l2skowron/IoT-PostureMonitor/Projekt_sem5/Dokumentacja/Dane_katalogowe/Programowanie_w_jezyku_Kotlin.pdf

# Programowanie w języku Kotlin

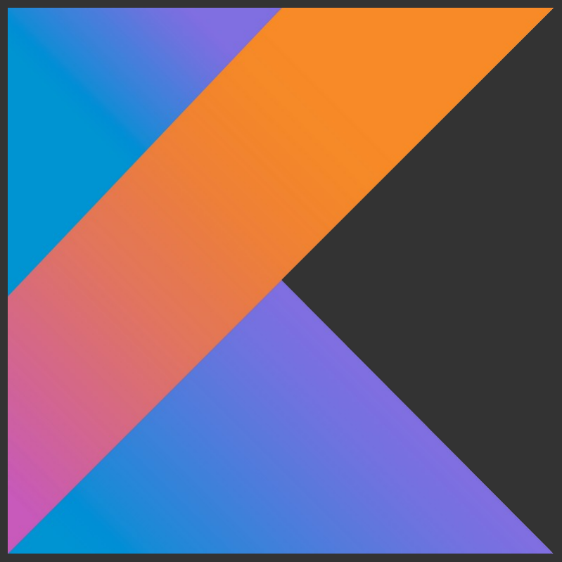
[picture p7: figure]

## dr inż. Michał Sawicki

## Politechnika Śląska

wersja: 15.10.2021

# Literatura

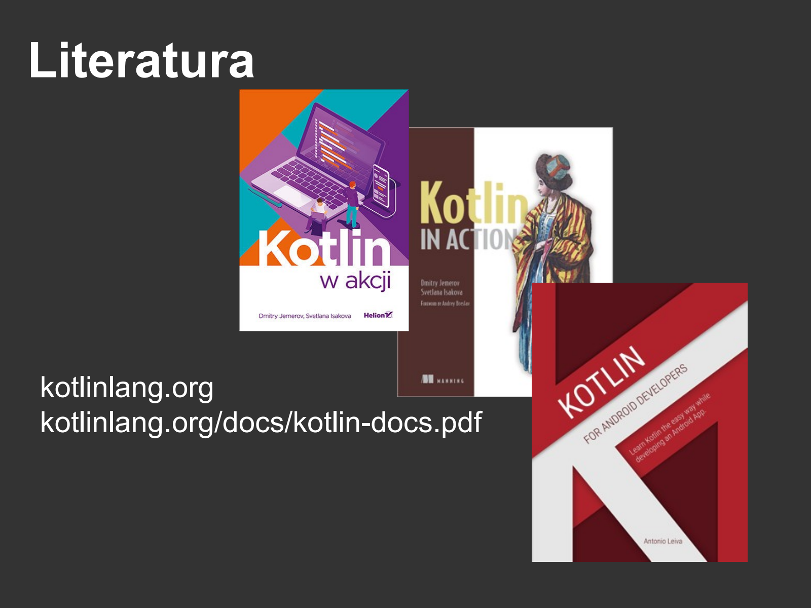
[picture p8: page 2]

## kotlinlang.org kotlinlang.org/docs/kotlin-docs.pdf

Nie tylko dinozaury...

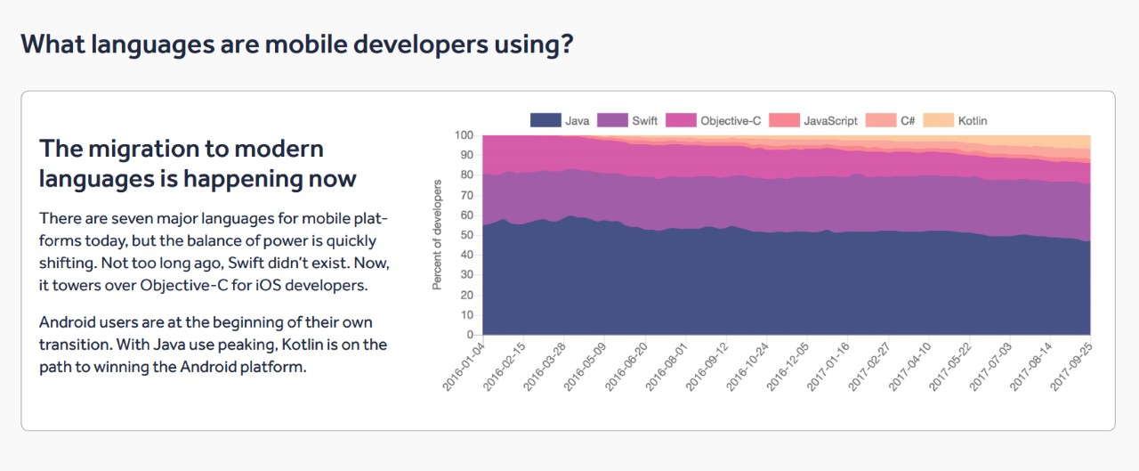
[picture p9: figure]

## Java na Androidzie umiera. Deweloperzy, którzy nie będą się posługiwać Kotlinem, mogą wkrótce

podzielić los dinozaurów...

# Kotlin – ogólna charakterystyka

## λ Cel: naprawa problemów ze składnią Javy, wzbogacenie

języka o rozwiązania znane z innych języków.
λ Nie wymaga stosowania średników (średniki są opcjonalne). λ Kotlin jest kompatybilny z JDK6.

## λ Aplikacja napisana w Kotlinie działa nie wolniej niż aplikacja

napisana w Javie.

## λ Kotlin zapewnia w pełni interoperacyjność z Javą, możliwe

są rozwiązania hybrydowe.
λ Istnieje konwerter kodu z Javy do Kotlina.
λ Możliwa jest kompilacja kodu Kotlina do kodu maszynowego, nie pośredniego (z wykorzystaniem LLVM).

# Kotlin – ogólna charakterystyka

## λ W Kotlinie nie ma metod, są za to funkcje

członkowskie (lub prościej funkcje).

## λ Indeksy numerowane są od zera (jak w rodzinie

języka C).
λ Składowe klas domyślnie są publiczne.
λ W Kotlinie możliwe jest zagnieżdżanie funkcji. λ Pliki z kodem Kotlina mają rozszerzenie .kt.

## λ Klasą bazową dla wszystkich klas jest Any (nie

JObject).

# Kotlin

ü | Obiektowy
ü | Strukturalny
ü | Funkcyjny

ü

# Imperatywny ü Statycznie typowany

# Kotlin – zastosowanie

## λ Aplikacje desktopowe

## λ Aplikacje webowe (transkodowanie do JavaScript)

## λ Aplikacje wbudowane

## λ Aplikacje mobilne

# Warsztat programisty Kotlina

## - Maszyna wirtualna Javy (JVM) - Zintegrowane środowisko programistyczne (IDE) → IntelliJ IDEA → Eclipse (wymaga dodatku) → NetBeans (wymaga dodatku) → Online try.kotlinlang.org

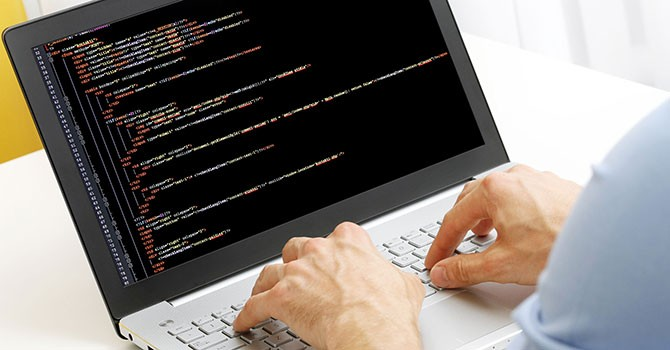
[picture p10: figure]

# Szkielet prostego programu

## package pl.polsl

## fun main(args :Array<String>) :Unit

{

## //cialo funkcji

}

Unit jest odpowiednikiem void i może być pomijany. Unit jest odpowiednikiem void i może być pomijany.

# Witaj Kotlinie!

## package pl.polsl

## fun main(args:Array<String>)

{

## println("Witaj Kotlinie!")

}

# Ciało blokowe funkcji

# package pl.polsl

# fun funkcja(): Int

{

# return 5

}

# Ciało wyrażeniowe funkcji

# package pl.polsl

# fun funkcja1(): Int = 5

# fun funkcja2() = 5

domniemanie typów

# Argumenty funkcji

## package pl.polsl

## fun funkcja(a: Int, b: Int, c: Int)

## funkcja(1,2,3)

## funkcja(a=1,b=2,c=3)

Wiele argumentów: vararg

# Podstawowe typy zmiennych

λ | Double (64)
λ | Float (32)
λ | Long (64)
λ | Int (32)
λ | Short (16)
λ | Byte (8)
λ | Char (nie może być traktowany jako liczba)
λ | Boolean (true, false)
λ | String
| W Kotlinie wszystko jest obiektem! W Kotlinie wszystko jest obiektem!

Przykłady wartości:
123
123L
0x0F
0b00110011 (nie ma zapisu oktalnego) 123.5
123.5e10
123.5f

# Deklaracja zmiennych

val – niemutowalna wartość zmiennej
var – mutowalna wartość zmiennej

val liczba: Int=5

val liczba=5

val liczba: Int
liczba=5

var liczba: Int=5
liczba=6

var liczba=5
liczba=6

Jeżeli zmienna (typ zerowalny) może przyjmować wartość null to musi to być wyraźnie zaznaczone poprzez ? : var zmienna :Typ?

Jeżeli zmienna (typ zerowalny) może przyjmować wartość null to musi to być wyraźnie zaznaczone poprzez ? : var zmienna :Typ?

# Rzutowanie jawne

## toByte() toShort() toInt() toLong() toFloat() toDouble() toChar()

### var liczba:Int=66 println(liczba.toChar())

# Tablice

λ | Tablice reprezentowane są przez generykę Array<T>, która zawiera funkcje get, set, size oraz przeciążony operator [].
λ | Tworzenie tablic z wykorzystaniem funkcji fabrykujących arrayOf() lub arrayOfNulls() lub z wykorzystaniem konstruktora Array(liczba, recepta_na_kolejne_wartości)
λ | Oddzielne klasy dla typów podstawowych: ByteArray, IntArray… i odpowiednio funkcje fabrykujące byteArrayOf, intArrayOf…
| var tablica1:IntArray=intArrayOf(1,2,3) println(tablica1[2])
| var tablica2= intArrayOf(1,2,3) println(tablica2.get(2))
| var slownik=arrayOf("Ala","ma","kota") println(slownik[1])
| var liczby1=Array<Int>(10,{i->i}) println(liczby1.get(2))
| var liczby2=Array(10,{i->i}) println(liczby2.get(2))

var tab=intArrayOf(1,2)
var tab2=tab
tab[0]=5
print(tab2[0])

Operator rozciągania:
*tab

# Łańcuchy znaków (String)

λ Łańcuchy znaków są niezmienne.

### λ Elementami łańcucha są znaki typu Char i jest dostęp do nich

poprzez operator [].

### λ Operatorem konkatenacji jest + (w tym rzutowanie niejawne, uwaga

na kolejność!).
λ Mogą zawierać znaki specjalne. Znak ucieczki to \ .

### λ Surowy łańcuch znaków z przejściami do nowych linii umieszczany

jest w ” ” ” ” ” ” .

### λ Szablony znakowe zawierają znak $, po którym podawane jest

wyrażenie.

# Szablony znakowe

λ Szablony znakowe (ze znakami specjalnymi lub surowe) zawierają znak $, po którym podawane jest wyrażenie.
λ Analogiczny mechanizm do rozwiązania z Basha.

val i=10
println("i=$i")

val s="abc"
println("$s.length wynosi ${s.length}")

val cena1=

"\$9.99"
val cena2=

"""${'$'}9.99"""

# Instrukcja warunkowa if

λ Instrukcja warunkowa if jest wyrażeniem, tj. może zwracać wartość. (Uwaga! try też może być wyrażeniem)
λ Nie ma operatora trynitarnego ? .
λ Jeżeli instrukcja if jest traktowana jako wyrażenie musi zawierać blok else.
λ Wyrażenie if może zawierać nietrywialne ciała (bloki), ale ostatnie wyrażenie w ciele jest wartością zwracaną przez blok.

if (1>0)
{
print("zawsze prawda")
}

println(if(1>1){print("uwaga!") "prawda"}
else{"falsz"})

# Instrukcja warunkowa when

λ Odpowiednik instrukcji switch.
λ Warunkiem nie musi być stała, może być wyrażeniem. λ Warunkiem może być weryfikacja typu.
λ Może być traktowana jako wyrażenie.
λ Alternatywa warunków za pomocą przecinka.

val a=0
println(when(a){
0 -> "zero"
0,1 -> "zero lub jeden"
in 0..10 -> "liczba z 0 do 10"
!in 20..30 -> "liczba poza 20 do 30" is Int -> "liczba typu Int"
else -> "sam juz nie wiem"
})

# Pętla for

λ Odpowiednik instrukcji foreach.

for (i in 1..3)
{
println(i)
}
for (i in 6 downTo 0 step 2) {
println(i)
}

# Pętle while i do..while

λ Działają jak w Javie.

var x=2
while(x>0)
{
println(x)
x--
}
do {
println(x)
x++
}while(x<2)

W Kotlinie mamy też W Kotlinie mamy też break i continue.

i | .

# Etykiety

λ Wykorzystywane do określenia poziomu zagnieżdżenia.

petlaZewnetrzna@ for (i in 1..10) {
petlaWewnetrzna@ for (j in 2..10) {
println(j)
if (i==j)
{
break@petlaZewnetrzna
}
}
}

# Lambda

{ /* argumenty */ -> /* cialo */ }

val suma = { x: Int, y: Int -> x+y }

{ it }

//Android - Java
button.setOnClickListener(new OnClickListener() {
@Override
public void onClick(View arg)
{
//cialo
}
});

//Android – Kotlin+lambda
button.setOnClickListener { /* cialo */ }

# Klasa

λ Słowo kluczowe class.
λ Klasa może nie mieć ciała.
λ Klasa domyślnie jest finalna, publiczna.

## λ Klasa może mieć podstawowy konstruktor i wiele

alternatywnych konstruktorów.
λ Ciało konstruktora podstawowego w bloku init.
λ Konstruktory alternatywne znajdują się w ciele klasy.

## λ Operatory == i ===

## λ Operator is

# Konstruktor podstawowy

class Student constructor(nazwisko: String) { }

class Student(nazwisko: String) { }

class Student(nazwisko: String)
{
val album=nazwisko
init
{
println("Po raz pierwszy mam studenta $nazwisko") }
val id=nazwisko
init
{
println("Drugi raz ten sam student $nazwisko") }
}

widoczność

# Konstruktor podstawowy – lista inicjalizacyjna

class Student(val nazwisko: String, var wiek: Int) {
//ciało klasy
}

# Konstruktor alternatywny i delegacja do innych konstruktorów

class Student
{
constructor(imie :String) {} }

Delegacja do konstruktora podstawowego:

class Student(val nazwisko :String)
{
constructor(nazwisko :String, imie :String) : this(nazwisko) {
//ciało konstruktora alternatywnego
}
}

# Konstruktor alternatywny i delegacja do innych konstruktorów

class Student
{
init
{
println("Podstawowy")
}
constructor(i: Int)
{
println("Alternatywny")
}
}

# Settery i gettery

class Student
{
var liczba: Int
get()
{
return liczba
}
set(n: Int)
{
liczba=n
}
}

class Student
{
var liczba: Int
get()=liczba
}

# Tworzenie obiektów klas

## val student1=Student()

## val student2=Student("Kowalski")

# NULL!

## obiekt?.funkcja()

## obiekt1 ?: obiekt2

## obiekt!!

asercja niezerowa

operator Elvisa

# Dziedziczenie klas

open class Figura(nazwa:String) {}

class Kwadrat(nazwa:String, bok:Int) : Figura(nazwa) {}

class Trojkat : Figura
{
constructor(nazwa:String) : super(nazwa) {}
}

super może być wykorzystane do wywołania funkcji klasy bazowej (lub zewnętrznej, możliwe etykiety) super może być wykorzystane do wywołania funkcji klasy bazowej (lub zewnętrznej, możliwe etykiety)

# Dziedziczenie klas – nadpisywanie funkcji

open class Figura
{
open fun funkcja1() {}
open fun funkcja2() {}
fun funkcja3() {}
}

open class Kwadrat:Figura
{
override fun funkcja1() {} final override funkcja2() {} }

# Dziedziczenie klas – nadpisywanie składników (pól)

open class Figura
{
open val i:Int get() {//ciało funkcji get} }

class Kwadrat:Figura
{
override val i:Int=0
}

class Trojkat(override val i:Int):Figura {}

class Kolo:Figura
{
override var i:Int=1
}

val → var val → var

# Implementacja interfejsu

# interface IFigura

{

# fun funkcja()

}

# class Kwadrat: IFigura

{

# override fun funkcja() {}

}

# Widoczność składników

## èPubliczna (public) – pola i metody dostępne na zewnątrz klasy

## èWewnętrzna (internal) – podobnie jak public, ale tylko wewnątrz modułu

## èPrywatna (private) – pola i metody dostępne jedynie z wnętrza (ciała) klasy

## èChronione (protected) – pola i metody dostępne tylko z wnętrza klasy lub klasy pochodnej

# Funkcja rozszerzająca

package strings

fun String.lastChar(): Char = this.get(this.length-1)

println("Politechnika".lastChar())

odbiorca

# Klasa wyliczeniowa

# enum class Plec { MEN, WOMEN

}

miękkie słowo kluczowe

## Klasa wyliczeniowa: - może zawierać funkcje

# Klasa i obiekt w jednym

### fun main(arg:Array<String>)

{

### Dyrektor.przedstawSie()

}

### object Dyrektor

{

### private val nazwisko="Kowalski" fun przedstawSie()

{

### println(nazwisko)

}
}

# Inne elementy Kotlina

## èKlasy danych (data class)

## èKlasy zamknięte (sealed class)

## èGeneryki (analogicznie jak w Javie)

## èOperator !== oraz :: - pobranie referencji funkcji

## èFunkcje standardowe

# Android lubi Kotlina

class MainActivity : Activity(), View.OnClickListener {
override fun onCreate(savedInstanceState: Bundle?) {
super.onCreate(savedInstanceState) setContentView(R.layout.activity_main)
val przycisk: Button =findViewById(R.id.button) przycisk.setOnClickListener(this)
}
override fun onClick(v: View?)
{
Toast.makeText(applicationContext,"Hello",Toast.LENGTH_SHORT).show() }
}
