l2skowron/IoT-PostureMonitor/Projekt_sem5/Dokumentacja/Karta.projektu.v.1_Łukasz.Skowron.pdf

| Katedra Grafiki Wizji Komputerowej i Systemów Cyfrowych Karta projektu SMiW

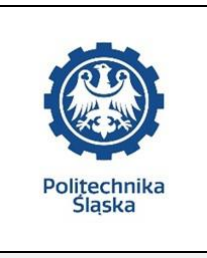
[picture p13: figure]

Rok akademicki | Rodzaj studiów*: SSI Glw/SSI Ktw/NSI Glw | Dizeń tygodnia i godzina zajęć: | Numer sekcji:
2024/2025 | SSI Glw | Poniedziałek 11:30 | 2
Imię: Nazwisko: | Łukasz | Prowadzący (inicjały): OA/JP/GB/KP | JP

## Skowron

## Temat projektu

Nakładka na fotel monitorująca postawę użytkownika.

Opis głównych założeń projektu:

Materiałowa nakładka umożliwiająca montaż na większość foteli komputerowych. Zbieranie danych z pomocą czujników tensometrycznych. Czujniki umieszczone pod udami siedzącego o zakresie pomiarowym do 50 kg. Czujniki umieszczone na oparciu w odcinku lędźwiowym, środkowym i na wysokości łopatek o zakresie pomiarowym do 20 kg. Bezprzewodowa komunikacja pomiędzy mikrokontrolerami (pomiarowym i odpowiedzialnym za wyświetlacz). Możliwość kalibracji poprawnej postawy użytkownika z pomocą ekranu. Sygnalizacja stanu postawy z pomocą diody RGB.

Rodzaj zasilania:

Stałe, dla modułu z wyświetlaczem. Bateryjne, dla modułu pomiarowego przymocowanego do nakładki.
