l2skowron/IoT-PostureMonitor/Projekty PCB/Projekt podłączenia/Moduł_pomiarowy_Łukasz.Skowron_mnt.png

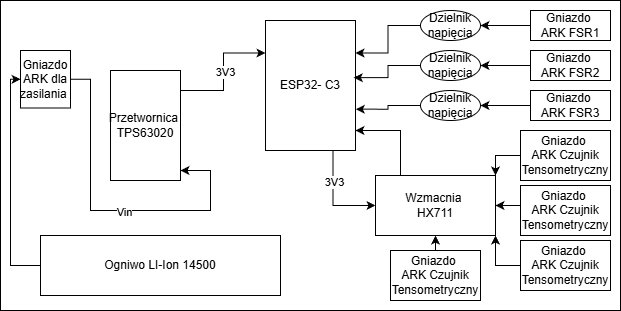
Projekty PCB/Projekt podłączenia/Moduł_pomiarowy_Łukasz.Skowron_mnt.png
