l2skowron/IoT-PostureMonitor/Schematy blokowe/Analiza_i_wybór_elementów_moduł_UI.png

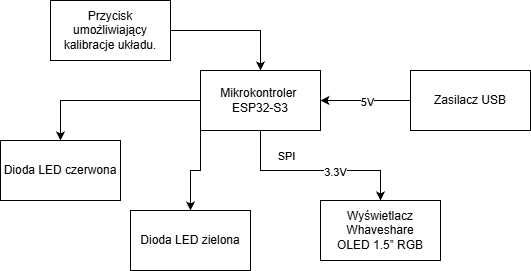
Schematy blokowe/Analiza_i_wybór_elementów_moduł_UI.png
