l2skowron/IoT-PostureMonitor/Schematy ideowe/Schemat_moduł_pomiarowy.png

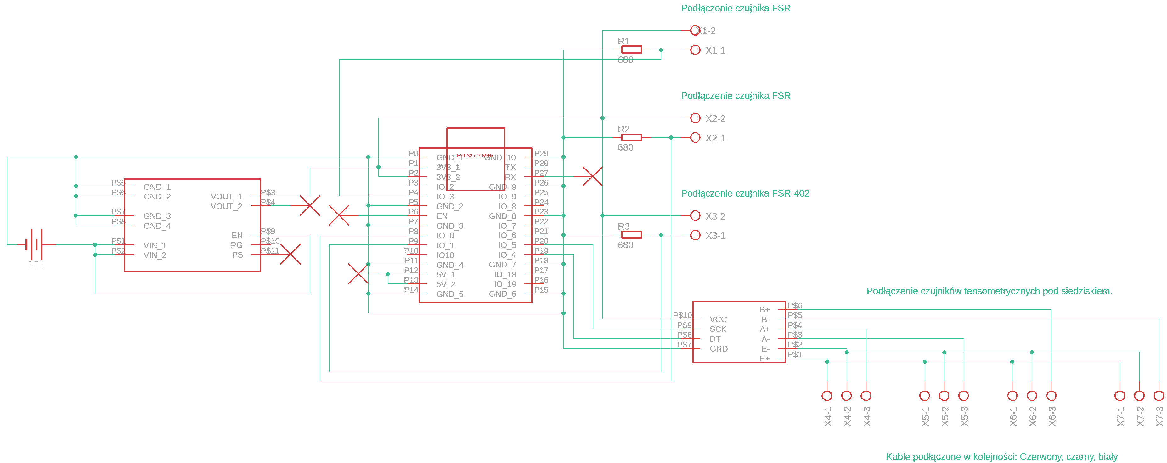
Schematy ideowe/Schemat_moduł_pomiarowy.png
