l2skowron/IoT-PostureMonitor/Schematy ideowe/Schemat_moduł_wyświetlacza.png

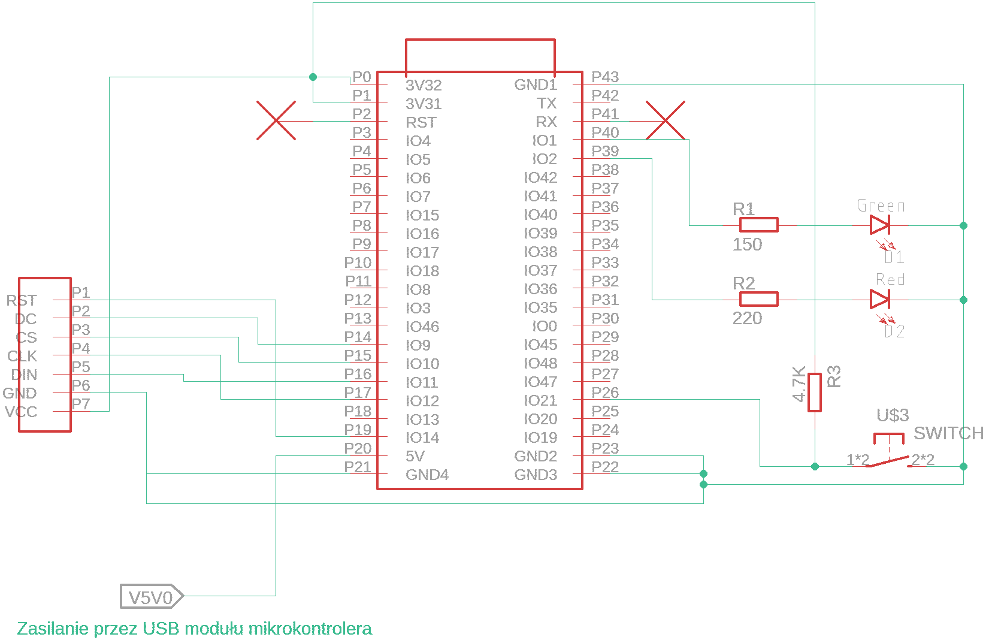
Schematy ideowe/Schemat_moduł_wyświetlacza.png
