l2skowron/IoT-PostureMonitor/Projekt_sem5/CHANGELOG.md

# Changelog	

Wszystkie istotne zmiany podczas tworzenia projektu zostały umieszczone w tym pliku.
## [1.1] - 2026-02-03

## Dodano
- prezentacja działania układu

## [1.0] - 2026-02-02

## Dodano
- dodanie nowego modułu przetwornicy,
- stworzenie pierwszej pełnej wersji finalnej.

## [0.9] - 2026-01-29

## Dodano 
-  dodanie podkładki na czujnikach zlokalizowanych na oparciu w celu lepszego pobierania nacisku.
-  implementacja tymczasowego zasilania bateryjnego z użyciem stabilizatora zlokalizowanego na module mikrokontrolera.
## [0.8] - 2026-01-27

## Dodano
- ukończenie implementacji modułu wyświetlacza,
- dodanie obsługi kalibracji oraz ekranów komunikacyjnych.
- implementacja zasilania bateryjnego modułu pomiarowego/awaria przetwornicy.

## [0.7] - 2026-01-25

## Dodano
- ukończenie implementacji modułu pomiarowego, w wersji z zasilaniem sieciowym.
- rozpoczęcie programowania układu.
- dodanie filtru medianowego dla ujednolicenia pomiarów czujnikami tensometrycznymi.

## [0.6] - 2026-01-21

### Dodano
- stworzenie prezentacji biznesowej projektu.
- rozpoczęcie montowania wersji finalnej projektu.

## [0.5] - 2026-01-10

### Dodano
- aktualizacja schematu ideowego.
- stworzenie projektu płytki PCB.
- zaprogramowanie komunikacji z pomocą protokołu ESP-NOW.

## [0.4] - 2025-12-12

### Dodano
- utworzenie pierwszego schematu podłączeń układu.
- rozpoczęcie testów poszczególnych komponentów układu:
	-czujników FSR,
	-wyświetlacza.

## [0.3] - 2025-11-30

### Dodano
- Ukończenie pełnej analizy tematu.
- Przesłanie pliku Analiza.v.1_Łukasz.Skowron.
- Zamówienie potrzebnych komponentów.

## [0.2] - 2025-11-10

### Dodano
- utworzenie pliku Analiza.v.1_Łukasz.Skowron podsumowującego użyte elementy i plany projektowe.
- dalsza analiza tematu. 

## [0.1] - 2025-10-21

### Dodano
- stworzenie karty projektu podsumowującej założenia.
- wstępna analiza tematu. Analiza możliwości implementacyjnych.
