l2skowron/IoT-PostureMonitor/Projekt_sem5/Hardware/PDF/Moduł_pomiarowy/Moduł_pomiarowy.v.1_Łukasz.Skowron.pdf

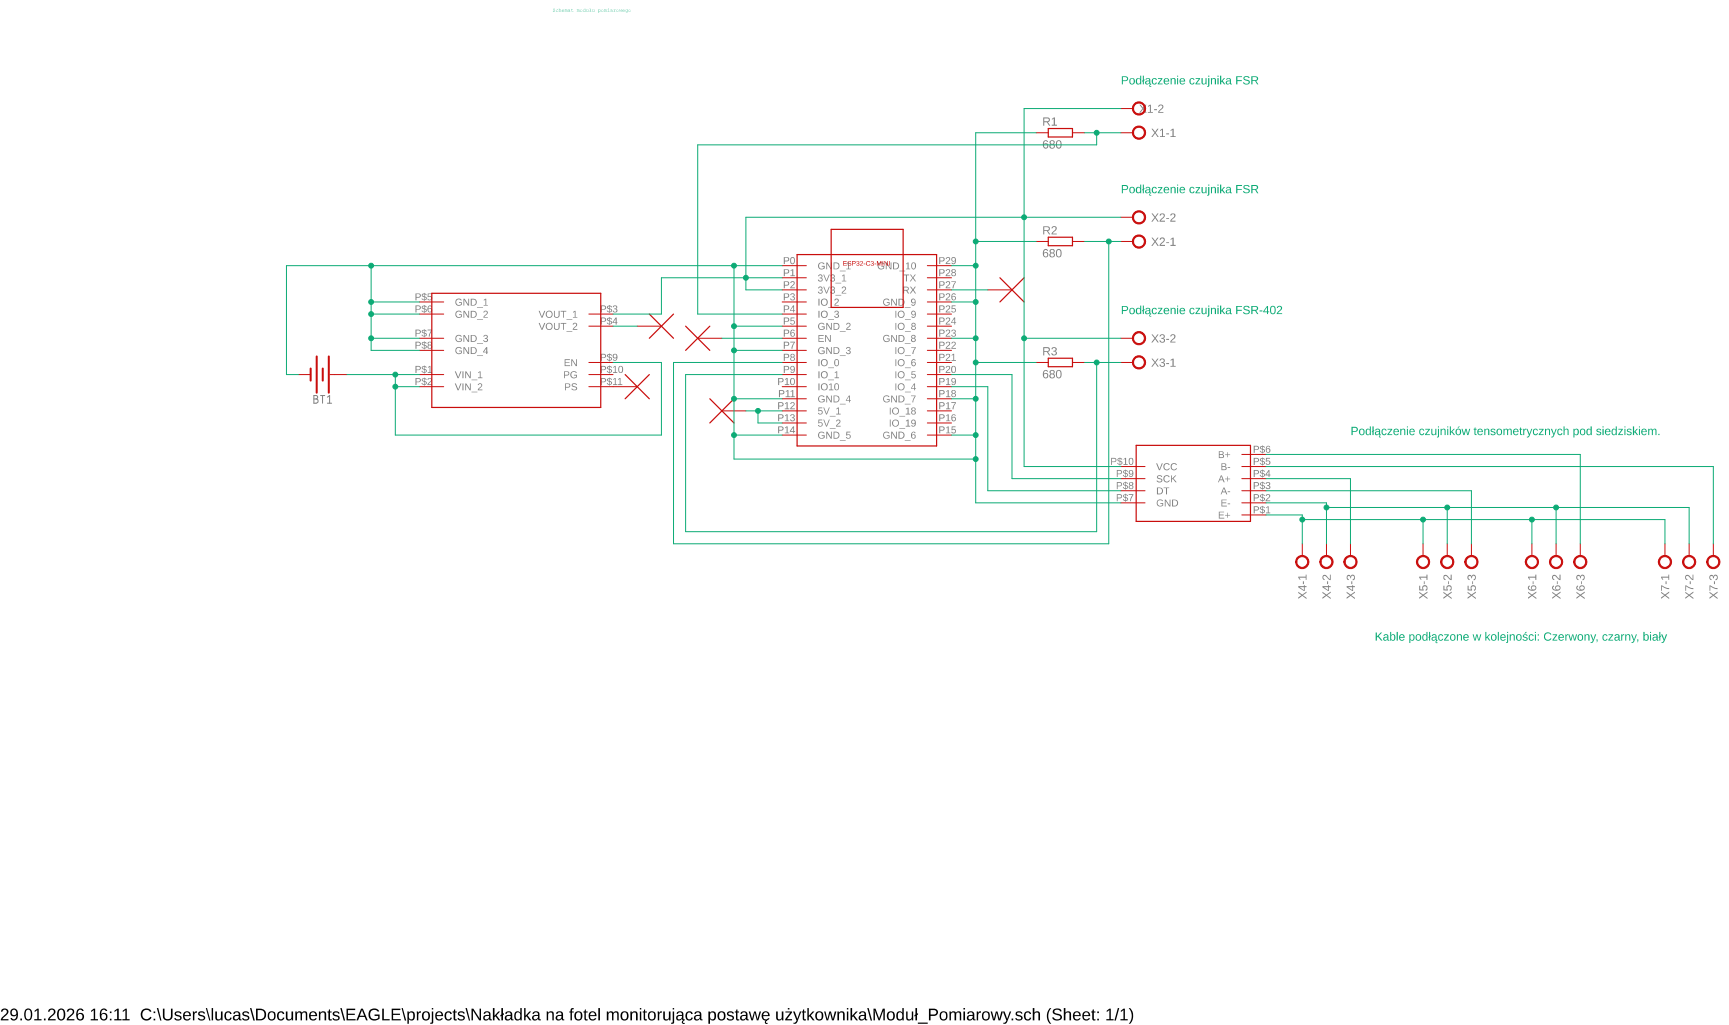
[picture p32: page 1]
