l2skowron/IoT-PostureMonitor/Projekt_sem5/Hardware/PDF/Moduł_pomiarowy/Moduł_pomiarowy_ŁukaszSkowron_bot.pdf

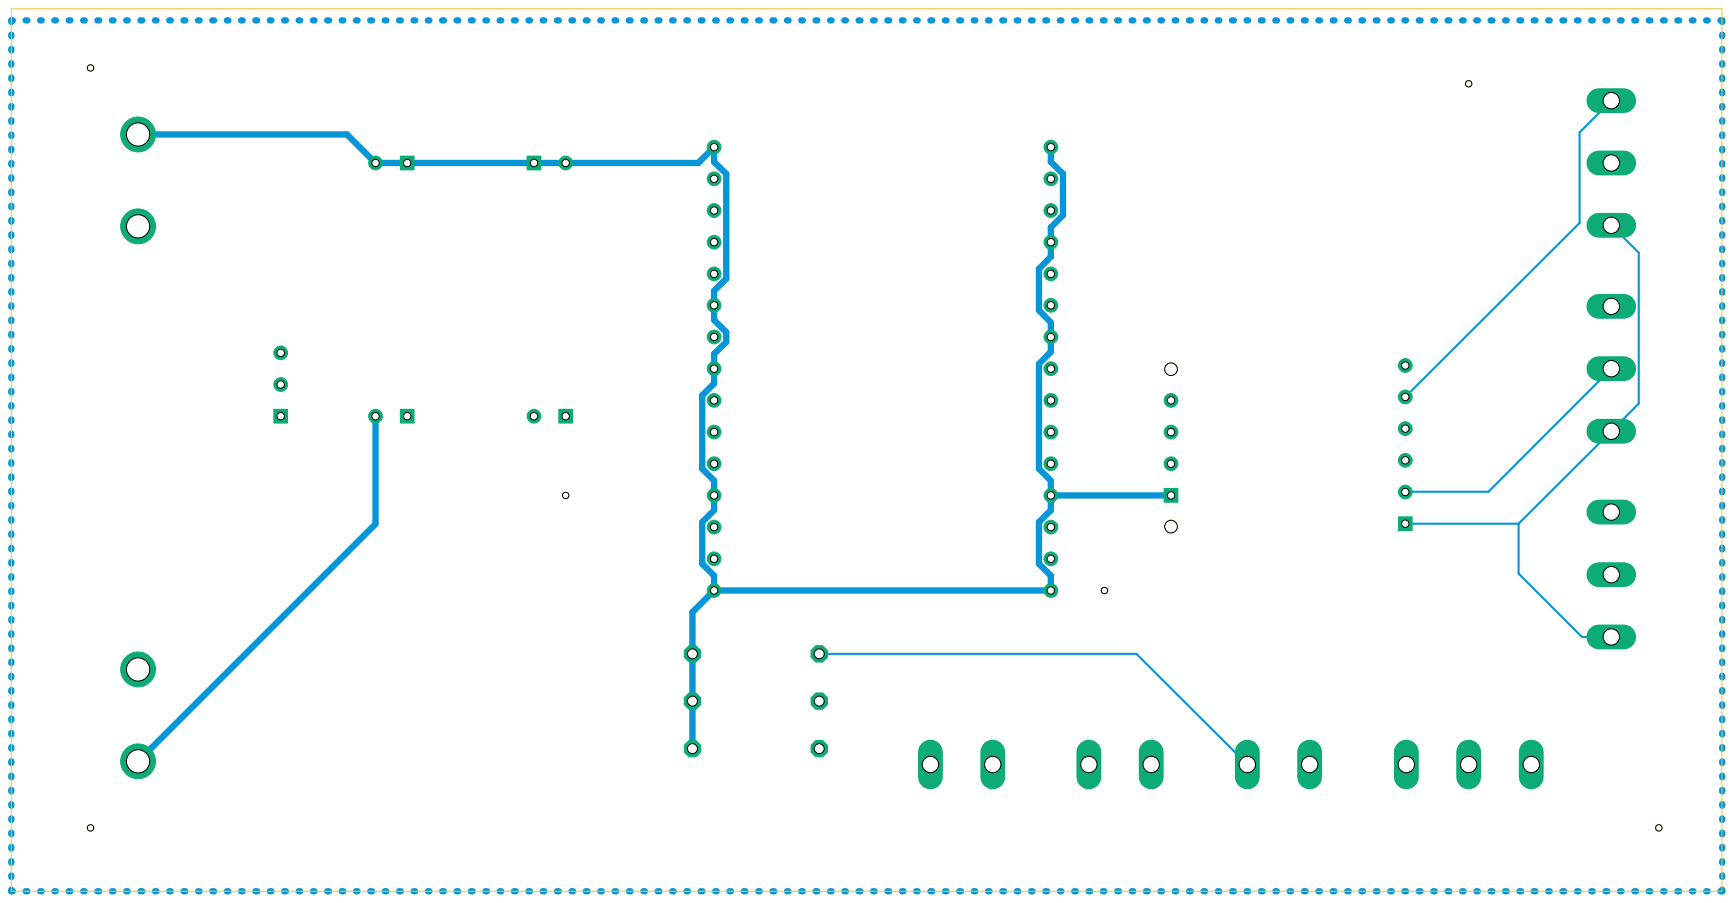
[picture p33: page 1]
