l2skowron/IoT-PostureMonitor/Projekt_sem5/Hardware/PDF/Moduł_pomiarowy/Moduł_pomiarowy_ŁukaszSkowron_bot_gnd.pdf

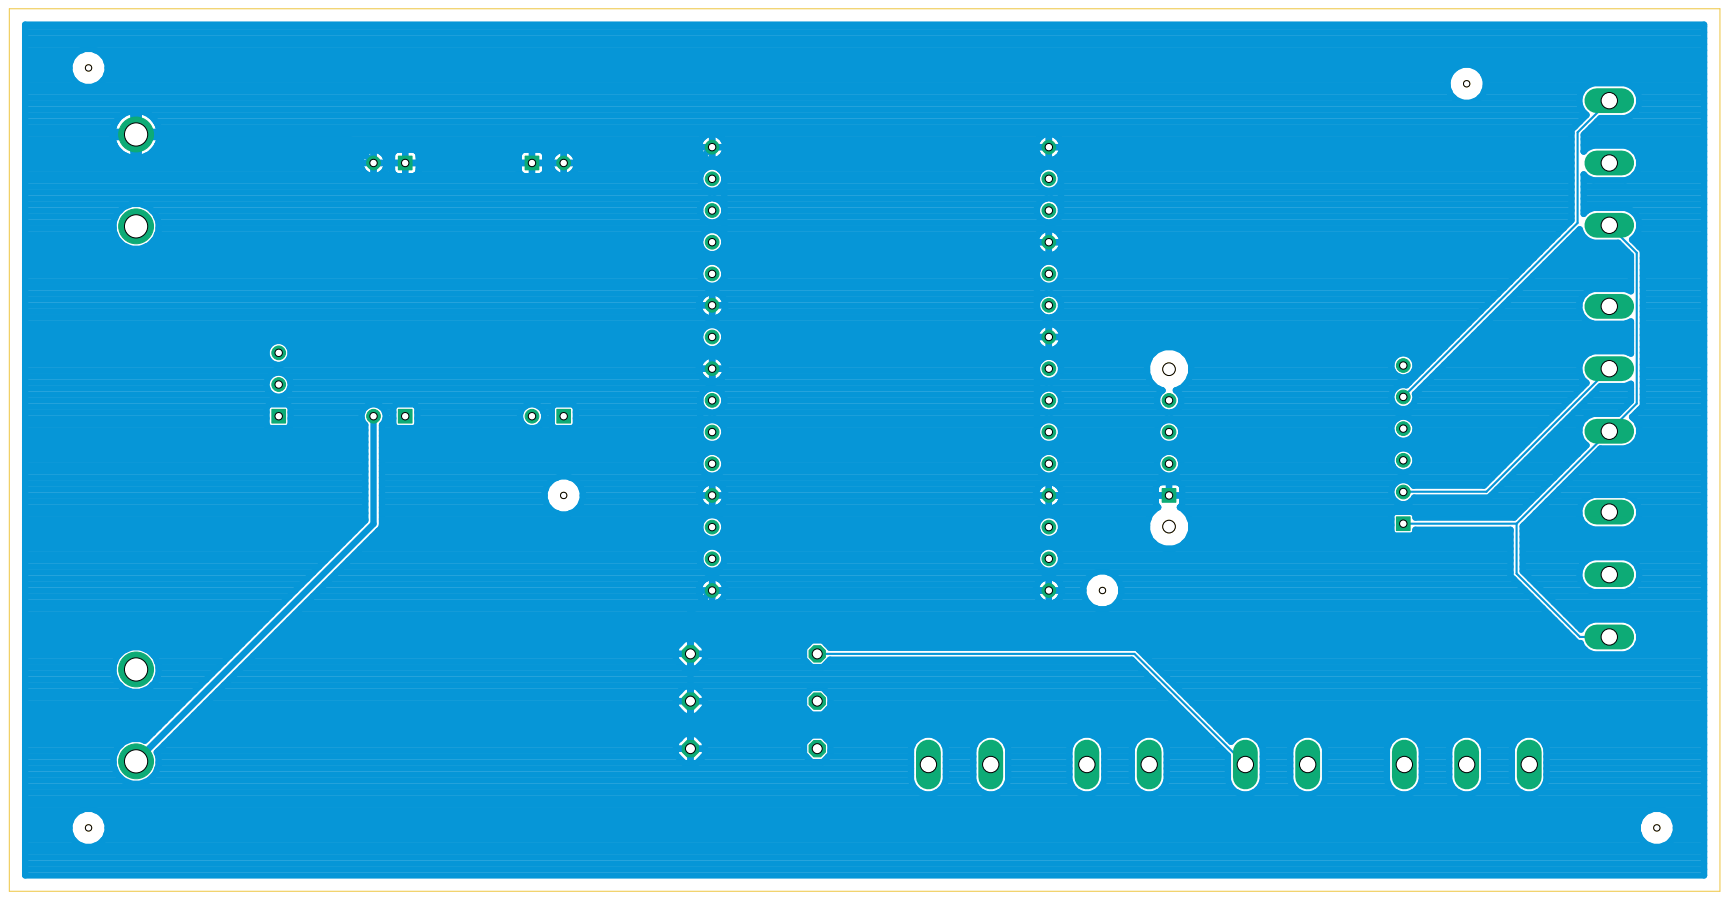
[picture p34: page 1]
