l2skowron/IoT-PostureMonitor/Projekt_sem5/Hardware/PDF/Moduł_pomiarowy/Moduł_pomiarowy_ŁukaszSkowron_top.pdf

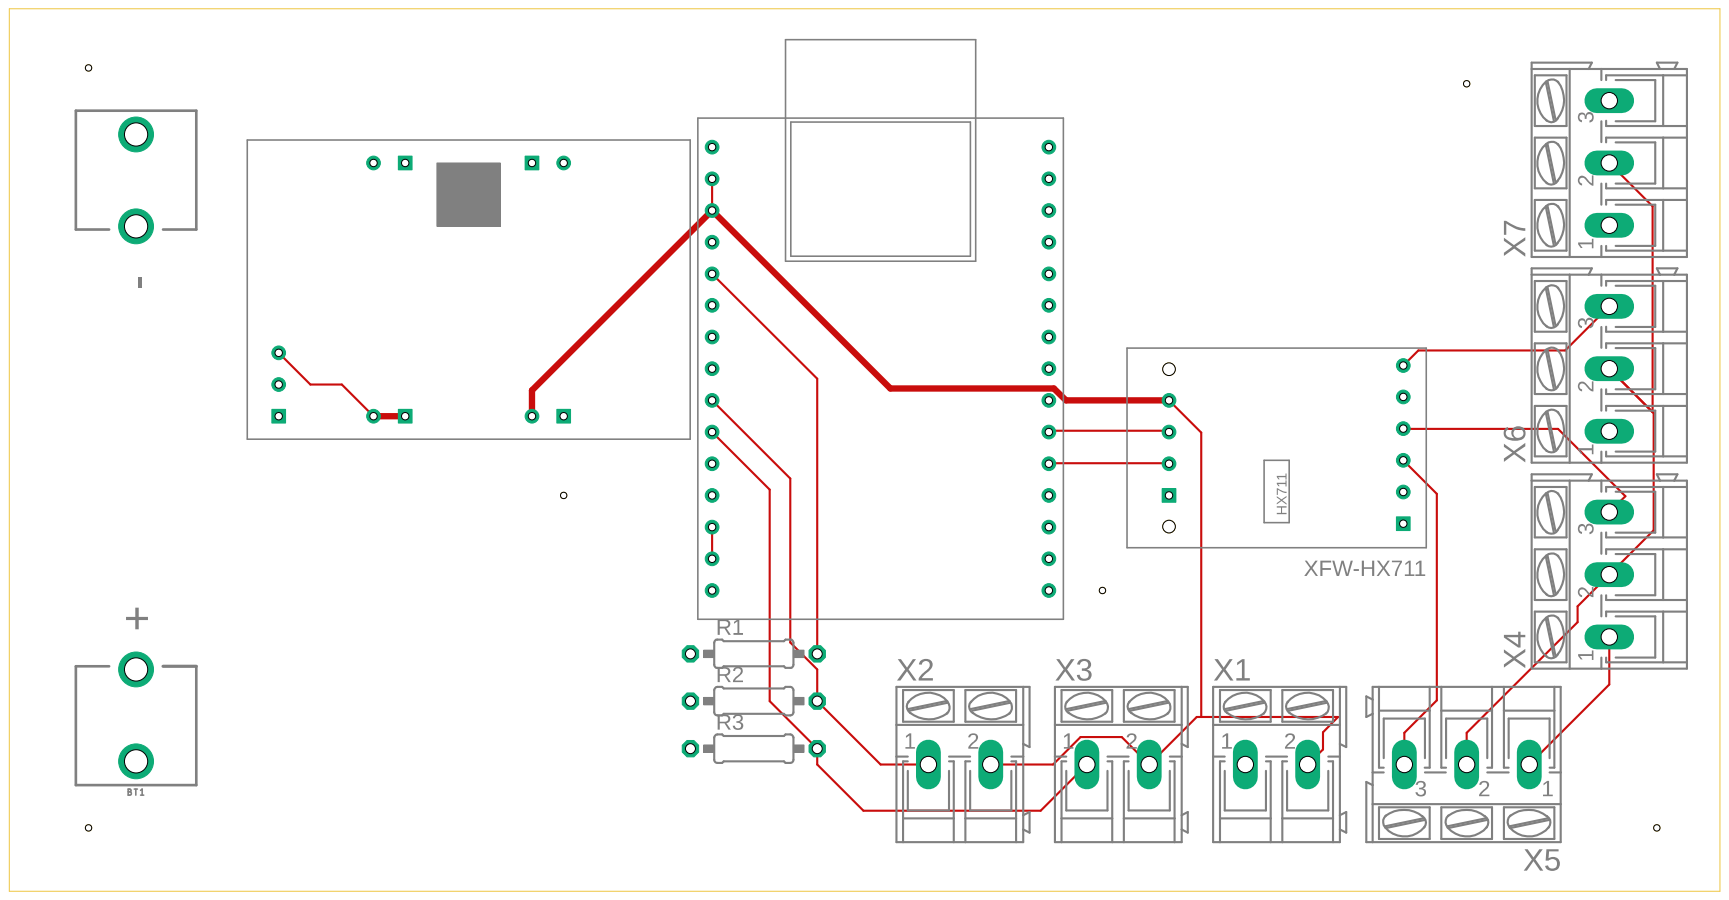
[picture p35: page 1]
