l2skowron/IoT-PostureMonitor/Projekt_sem5/Hardware/PDF/Moduł_wyświetlacza/Moduł_wyświetlacza.v.1_Łukasz.Skowron.pdf

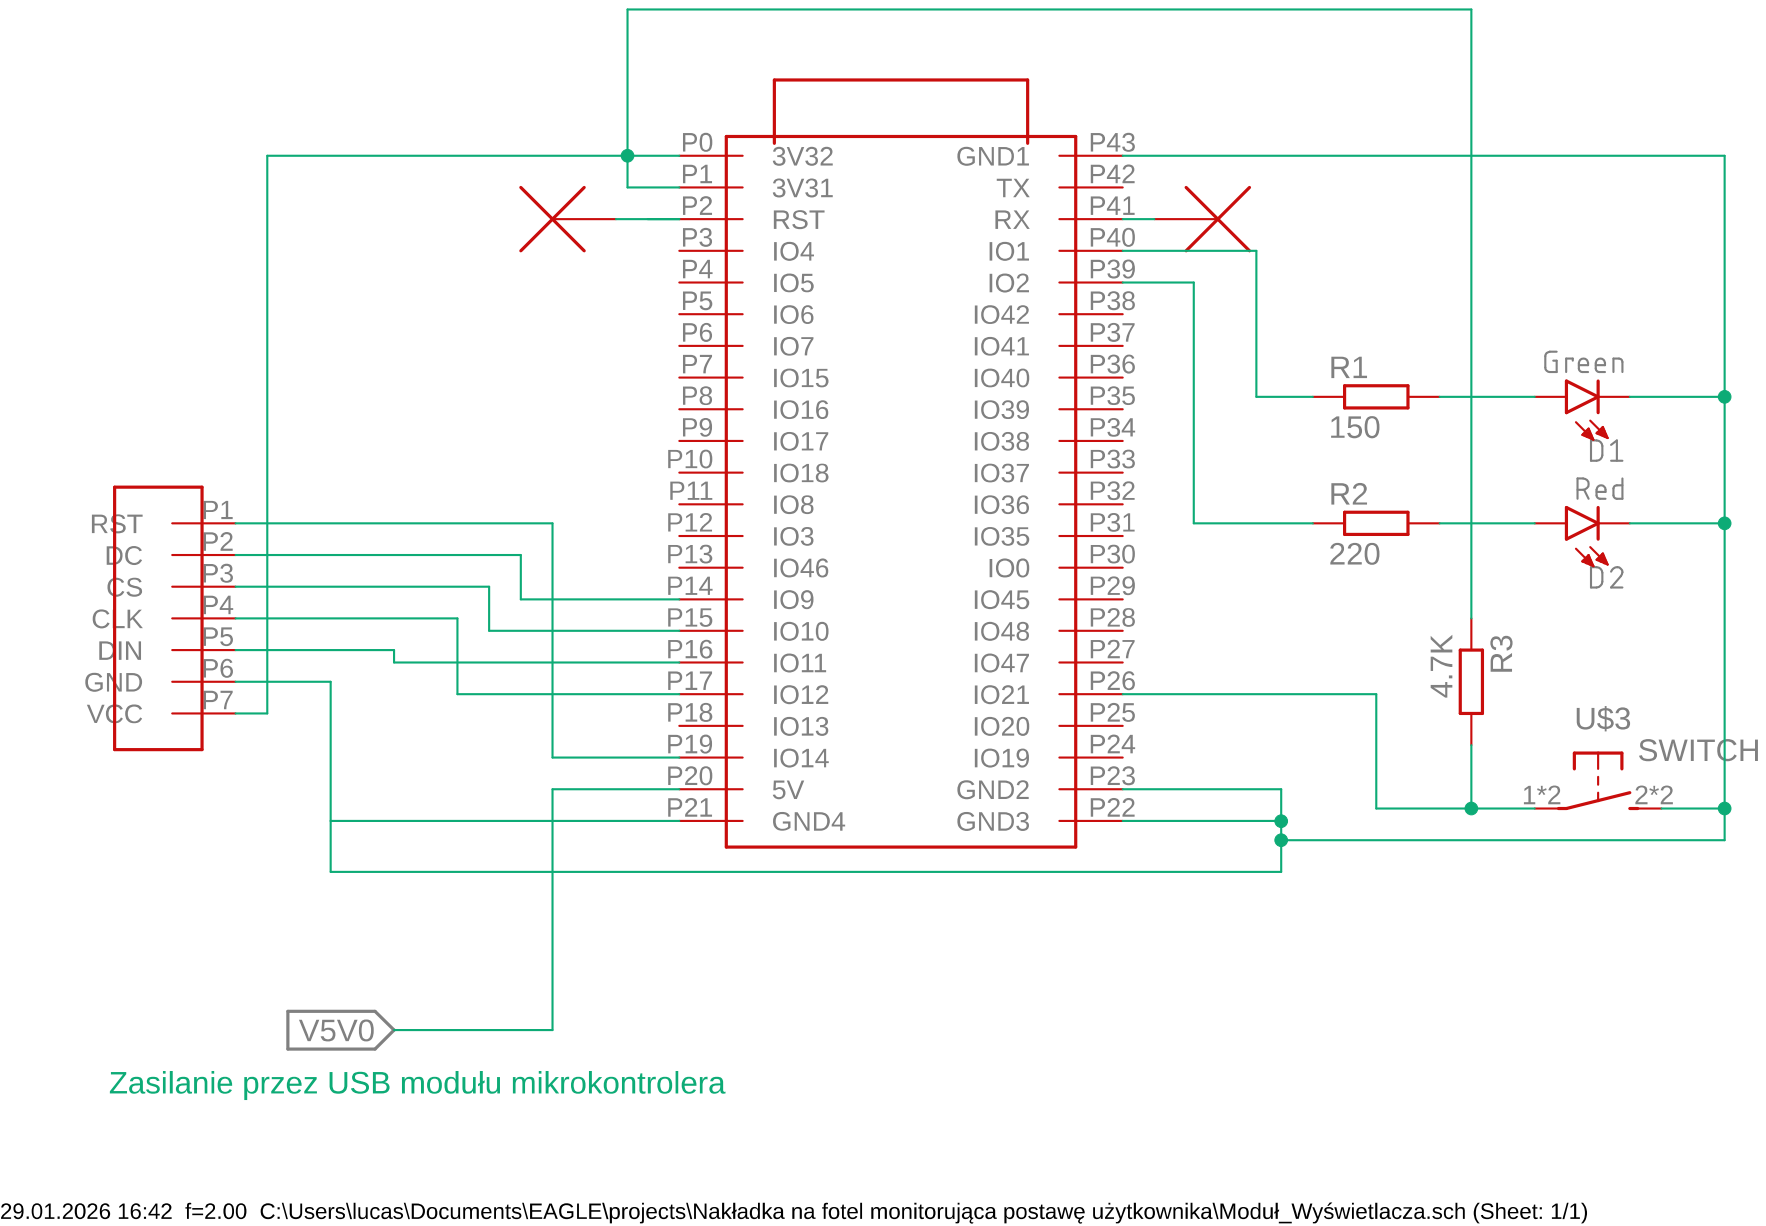
[picture p36: page 1]
