l2skowron/IoT-PostureMonitor/Projekt_sem5/Hardware/PDF/Moduł_wyświetlacza/Moduł_wyświetlacza_ŁukaszSkowron_bot.pdf

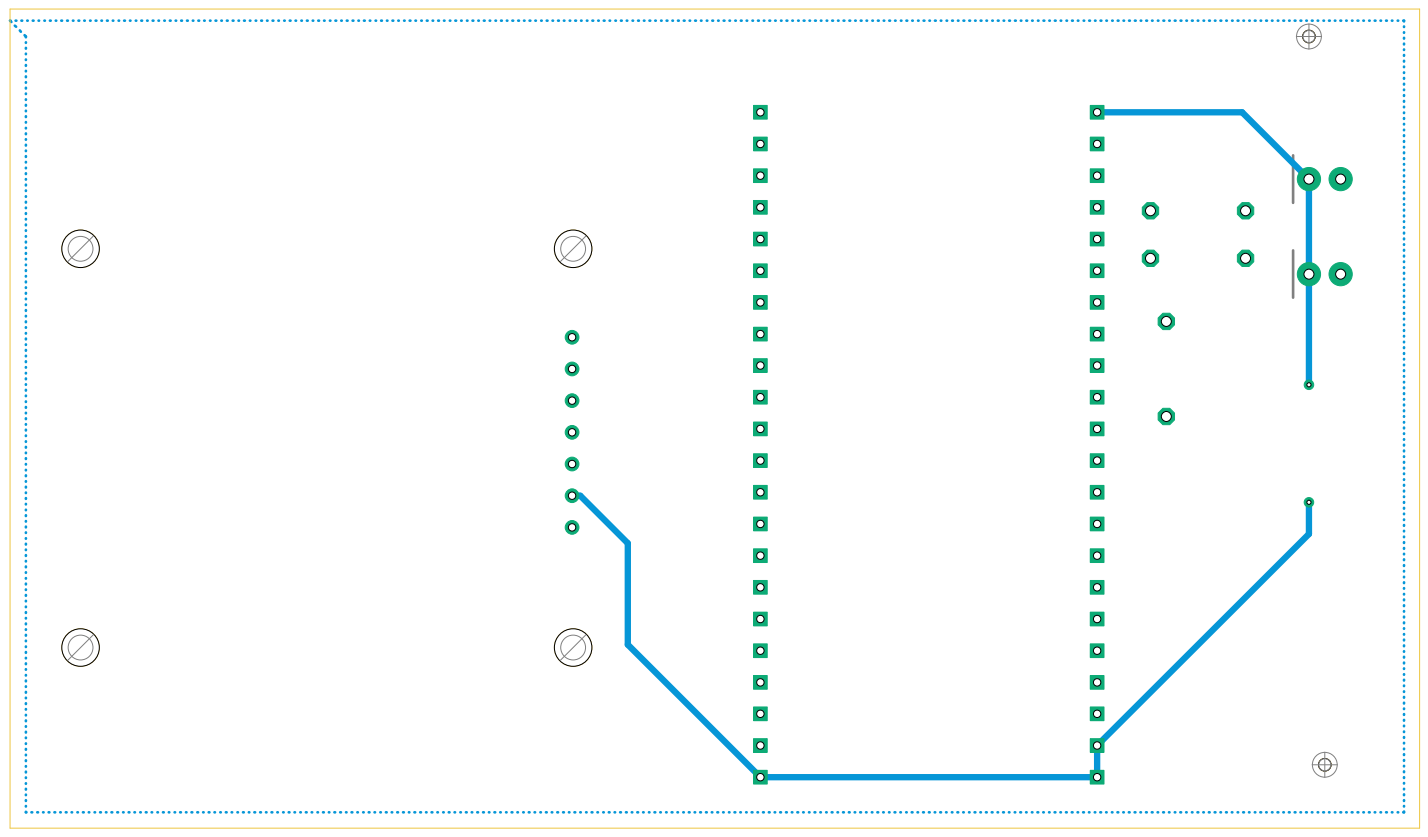
[picture p37: page 1]
