l2skowron/IoT-PostureMonitor/Projekt_sem5/Hardware/PDF/Moduł_wyświetlacza/Moduł_wyświetlacza_ŁukaszSkowron_bot_gnd.pdf

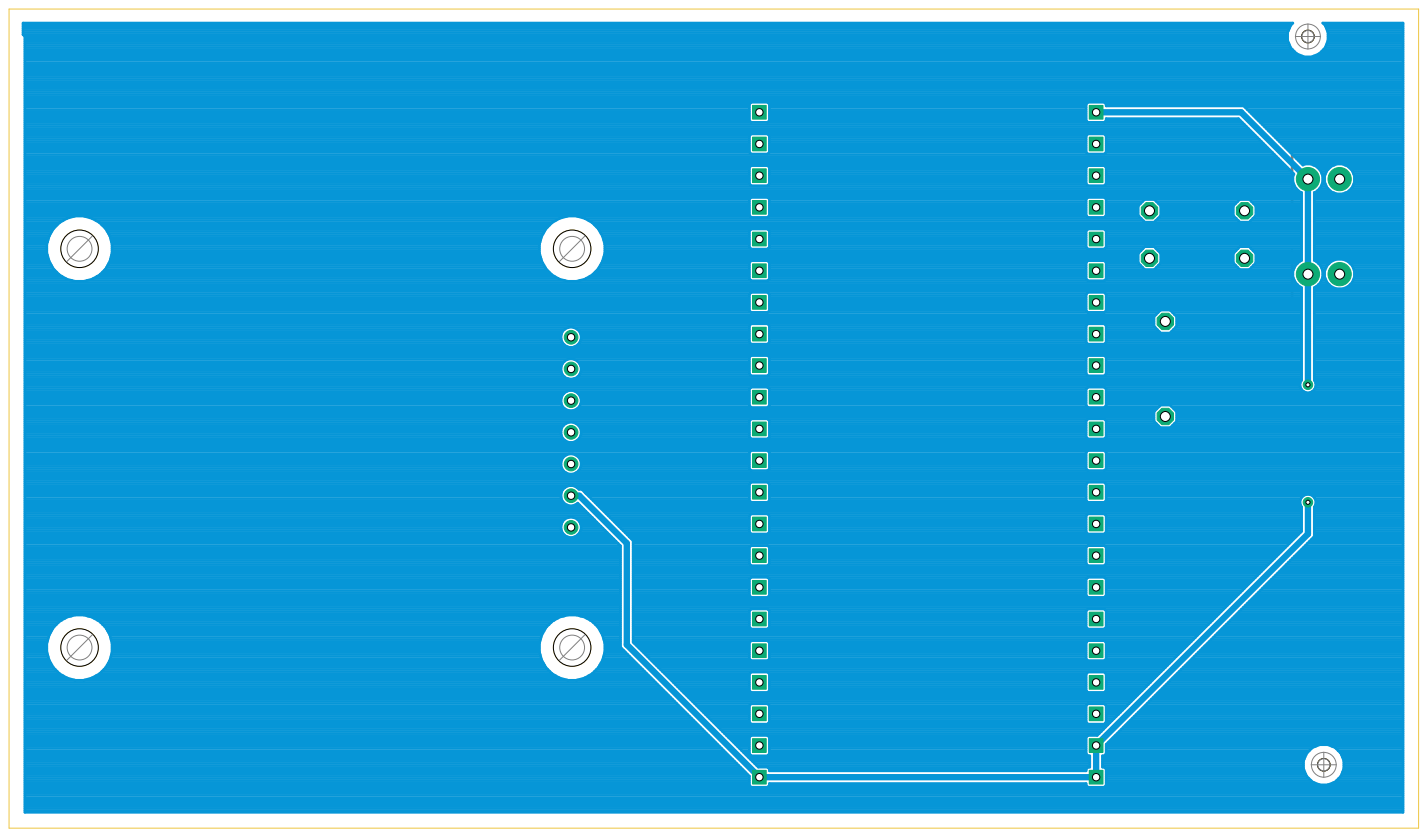
[picture p38: page 1]
