l2skowron/IoT-PostureMonitor/Projekt_sem5/Hardware/PDF/Moduł_wyświetlacza/Moduł_wyświetlacza_ŁukaszSkowron_top.pdf

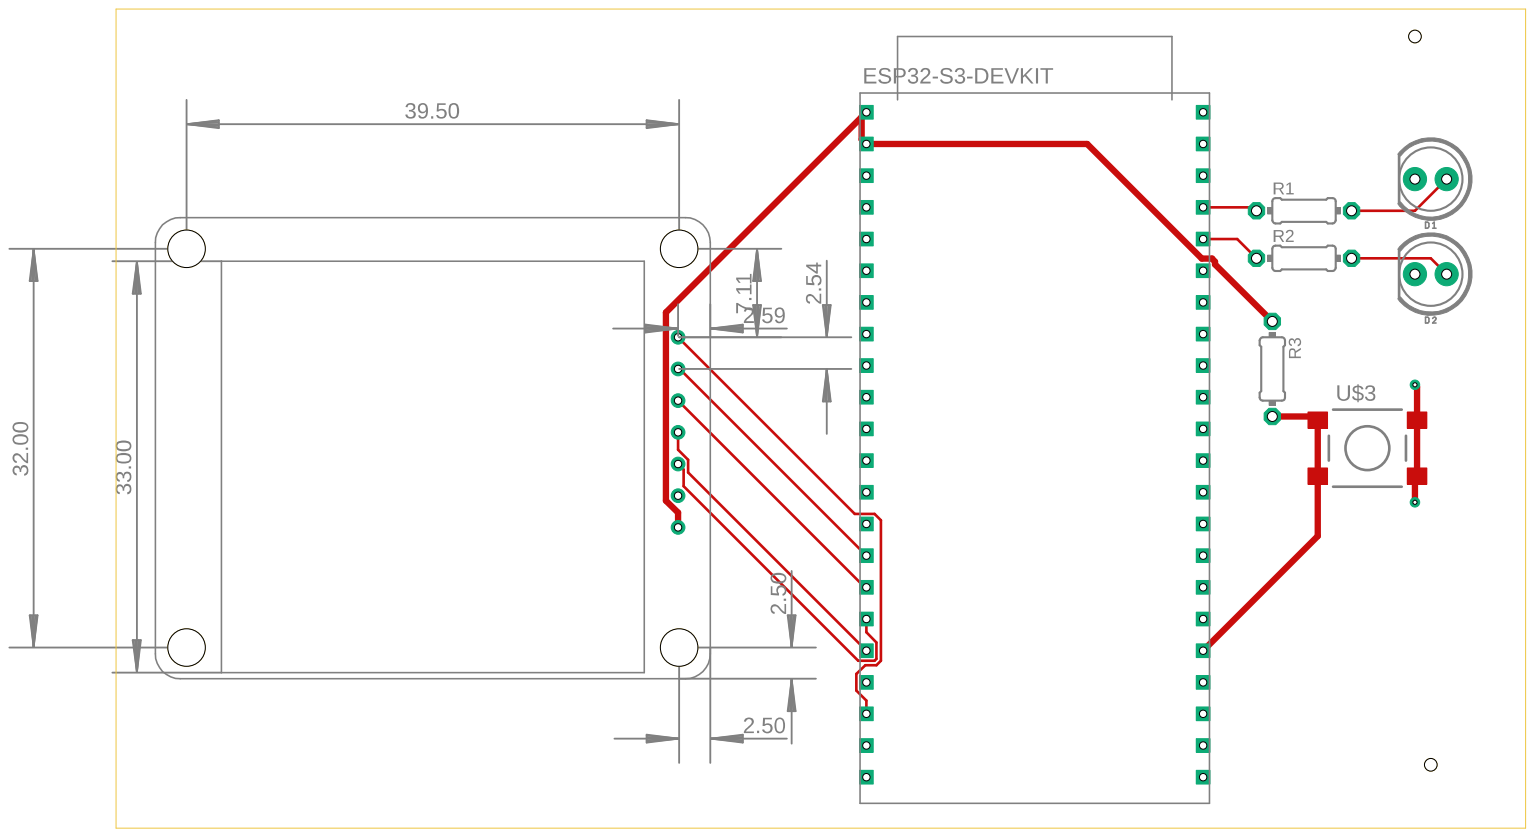
[picture p39: page 1]
