l2skowron/IoT-PostureMonitor/Projekt_sem5/Hardware/EAGLE/Moduł_wyświetlacza/Moduł_Wyświetlacza.brd

## EAGLE design Projekt_sem5/Hardware/EAGLE/Moduł_wyświetlacza/Moduł_Wyświetlacza.brd (2026-03-30)

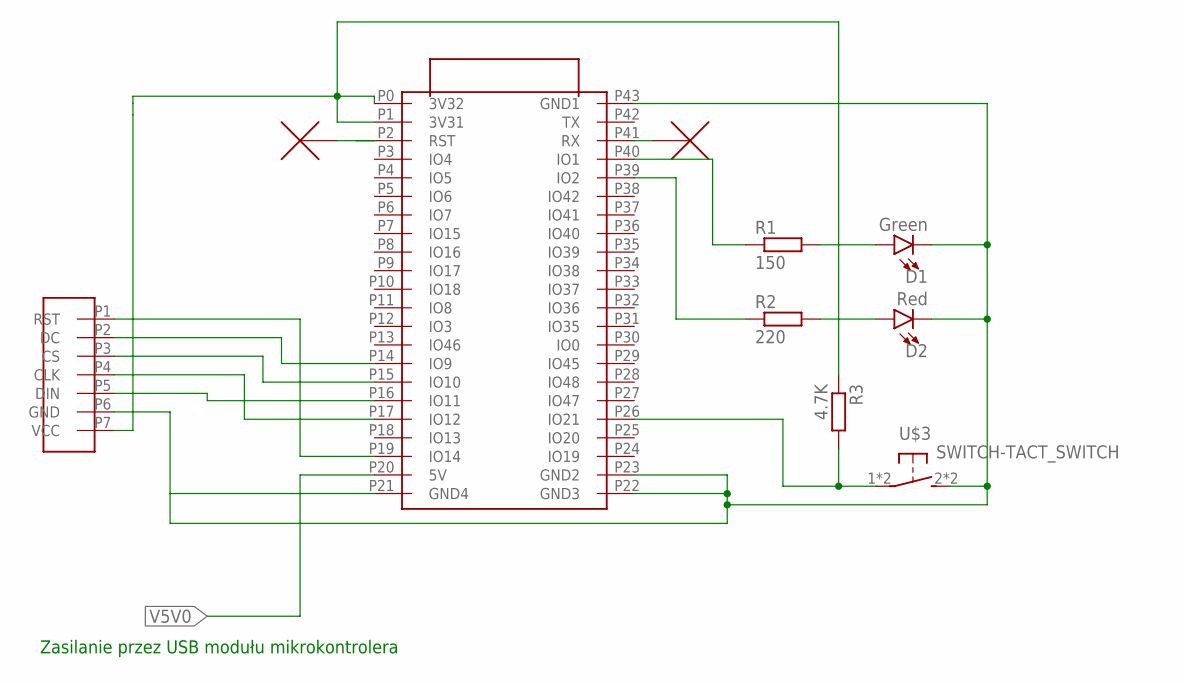
[picture p40: schematic Moduł_Wyświetlacza.sch]

Parts:
D1: Green; SPARKFUN-LED_LED_5MM
D2: Red; SPARKFUN-LED_LED_5MM
R1: 150; 0204/7
R2: 220; 0204/7
R3: 4.7K; 0204/7
U$1: PROJEKT_SE5_ESP32-S3-DEVKIT
U$2: PROJEKT_SE5_OLED_MODULE; PROJEKT_SE5_1.5INC_RGB_OLED
U$3: SWITCH-TACT_SWITCH; SWITCH-TACT_DTSM-6

Connections:
unnamed: D1.K (C), D2.K (C), U$1.P21 (GND4), U$1.P22 (GND3), U$1.P23 (GND2), U$1.P43 (GND1), U$2.P6 (GND), U$3.2, U$3.4 (2)
unnamed: U$1.P19 (IO14), U$2.P1 (RST)
unnamed: U$1.P14 (IO9), U$2.P2 (DC)
unnamed: U$1.P15 (IO10), U$2.P3 (CS)
unnamed: U$1.P17 (IO12), U$2.P4 (CLK)
unnamed: U$1.P16 (IO11), U$2.P5 (DIN)
unnamed: R3.2, U$1.P26 (IO21), U$3.1, U$3.3 (1)
unnamed: D2.A, R2.2
unnamed: D1.A, R1.2
unnamed: R1.1, U$1.P40 (IO1)
unnamed: R2.1, U$1.P39 (IO2)
unnamed: R3.1, U$1.P0 (3V32), U$1.P1 (3V31), U$2.P7 (VCC)
V5V0: U$1.P20 (5V)

Notes on the sheet:
Zasilanie przez USB modułu mikrokontrolera

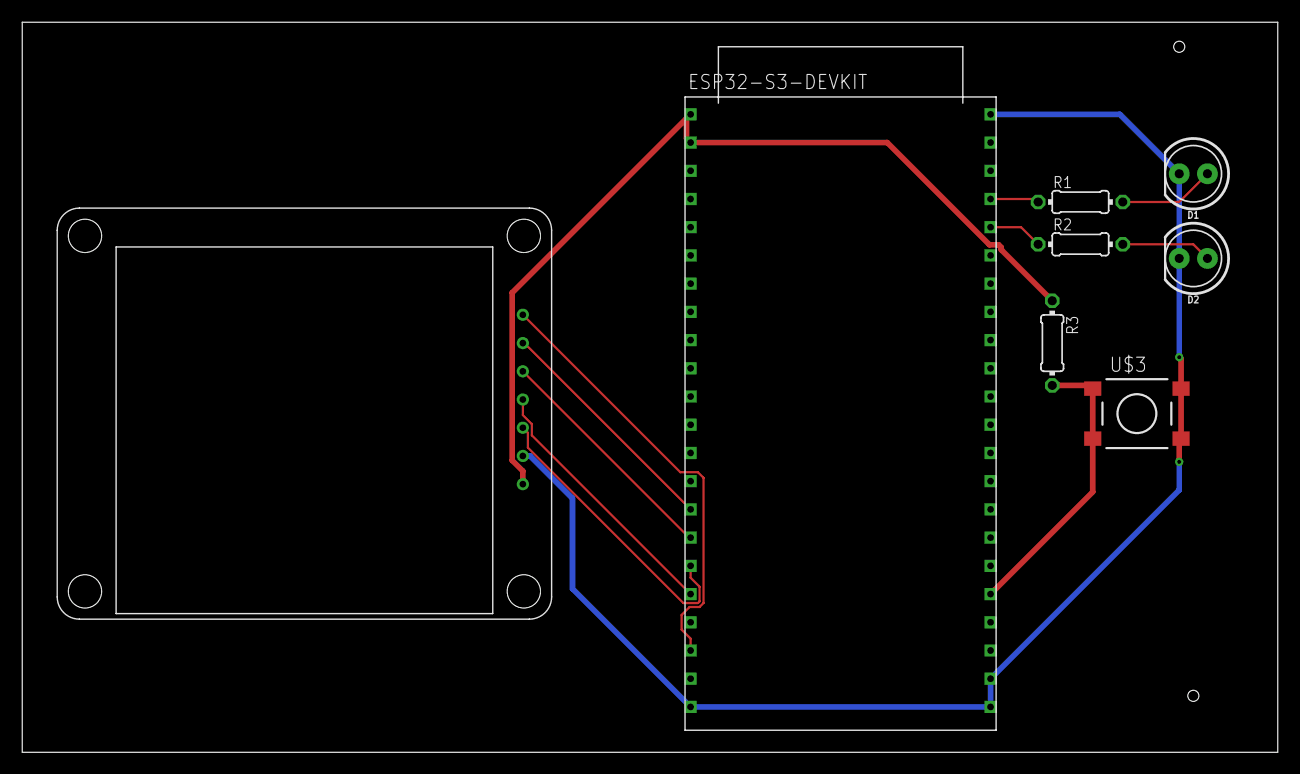
[picture p41: board Moduł_Wyświetlacza.brd from above]

Board: 2 copper layers, 113.0 x 65.7 mm, 8 parts (0 on the bottom side), 12 nets.
