l2skowron/IoT-PostureMonitor/Projekt_sem5/Hardware/EAGLE/Moduł_pomiarowy/Moduł_Pomiarowy.brd

## EAGLE design Projekt_sem5/Hardware/EAGLE/Moduł_pomiarowy/Moduł_Pomiarowy.brd (2026-03-30)

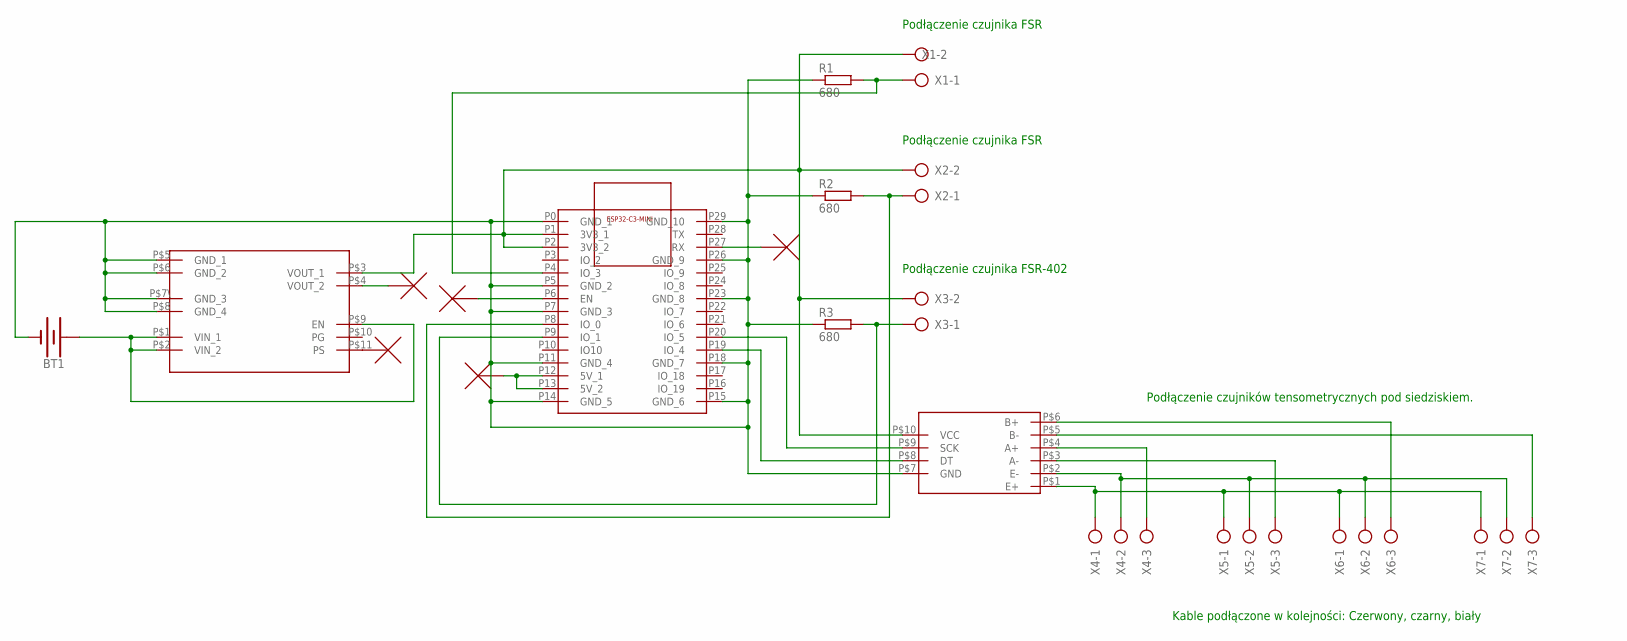
[picture p42: schematic Moduł_Pomiarowy.sch]

Parts:
BT1: SPARKFUN-BATTERIES_BATTERY-AA
R1, R2, R3: 680; 0207/10
U$1: PROJEKT_SE5_ESP32-C3-MINI-DEVKITESP32-C3-MINI; PROJEKT_SE5_ESP32-C3-MINI
U$2: PROJEKT_SE5_XFW-HX711; PROJEKT_SE5_XFV-HX711
U$3: PROJEKT_SE5_TPS63020-MODULE; PROJEKT_SE5_TPS63020
X1, X2, X3: AK300/2
X4, X5, X6, X7: AK300/3

Connections:
GND: BT1.GND@1 (-), R1.1, R2.1, R3.1, U$1.P0 (GND_1), U$1.P5 (GND_2), U$1.P7 (GND_3), U$1.P11 (GND_4), U$1.P14 (GND_5), U$1.P15 (GND_6), U$1.P18 (GND_7), U$1.P23 (GND_8), U$1.P26 (GND_9), U$1.P29 (GND_10), U$2.P$7 (GND), U$3.P$5 (GND_1), U$3.P$6 (GND_2), U$3.P$7\ (GND_3), U$3.P$8 (GND_4)
unnamed: BT1.PWR@1 (+), U$3.P$1 (VIN_1), U$3.P$2 (VIN_2), U$3.P$9 (EN)
unnamed: U$2.P$1 (E+), X4.1, X5.1, X6.1, X7.1
unnamed: U$2.P$2 (E-), X4.2, X5.2, X6.2, X7.2
unnamed: U$1.P1 (3V3_1), U$1.P2 (3V3_2), U$2.P$10 (VCC), U$3.P$3 (VOUT_1), X1.2, X2.2, X3.2
unnamed: U$2.P$4 (A+), X4.3
unnamed: U$2.P$3 (A-), X5.3
unnamed: U$2.P$6 (B+), X6.3
unnamed: R2.2, U$1.P8 (IO_0), X2.1
unnamed: R3.2, U$1.P9 (IO_1), X3.1
unnamed: R1.2, U$1.P4 (IO_3), X1.1
unnamed: U$2.P$5 (B-), X7.3
unnamed: U$1.P20 (IO_5), U$2.P$9 (SCK)
unnamed: U$1.P19 (IO_4), U$2.P$8 (DT)
unnamed: U$1.P12 (5V_1), U$1.P13 (5V_2)

Notes on the sheet:
Podłączenie czujnika FSR
Podłączenie czujnika FSR-402
Podłączenie czujników tensometrycznych pod siedziskiem.
Kable podłączone w kolejności: Czerwony, czarny, biały

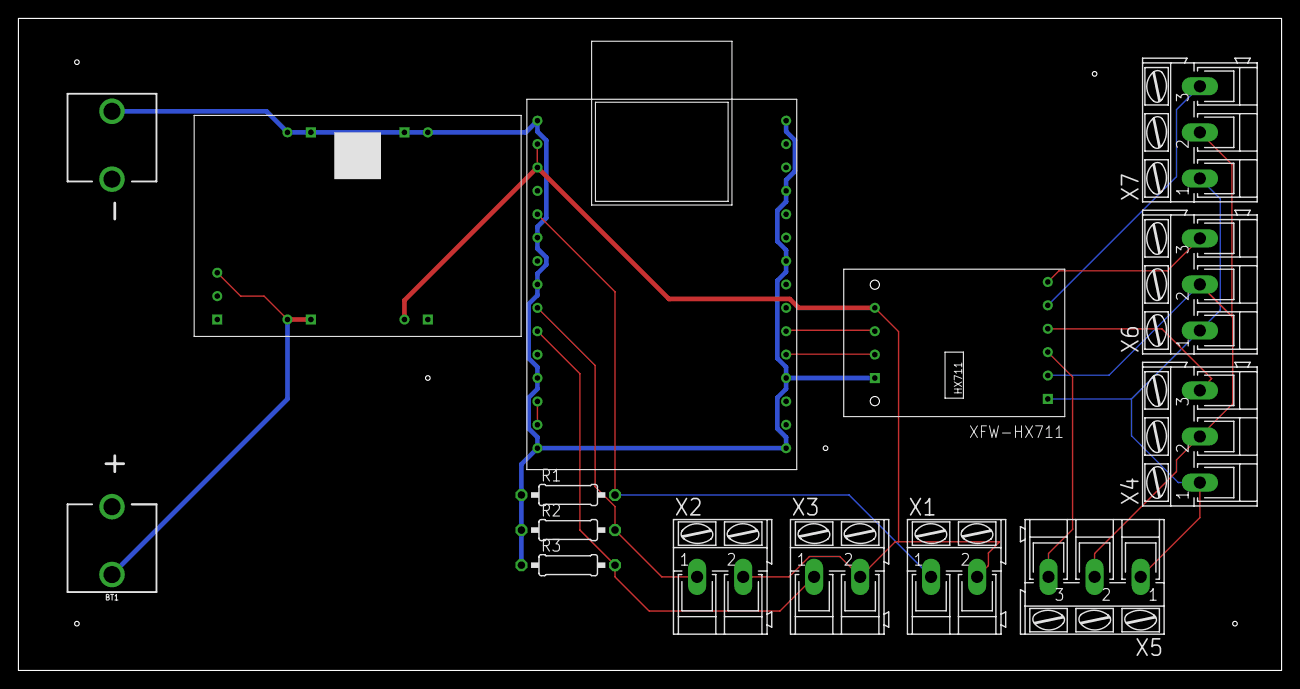
[picture p43: board Moduł_Pomiarowy.brd from above]

Board: 2 copper layers, 137.1 x 70.8 mm, 14 parts (0 on the bottom side), 15 nets.
